rjmdhr/Blinky-5.0/README.md

# Blinky-5.0
A "hello world" intro to PCB design provided by Contextual Electronics. I thought I should start out small before I get into more advanced projects I have in mind.

pcb-gif
