rjmdhr/Blinky-5.0/src/Blinky-5.0.kicad_pcb

## KiCad design src/Blinky-5.0.kicad_pcb (2021-05-21)

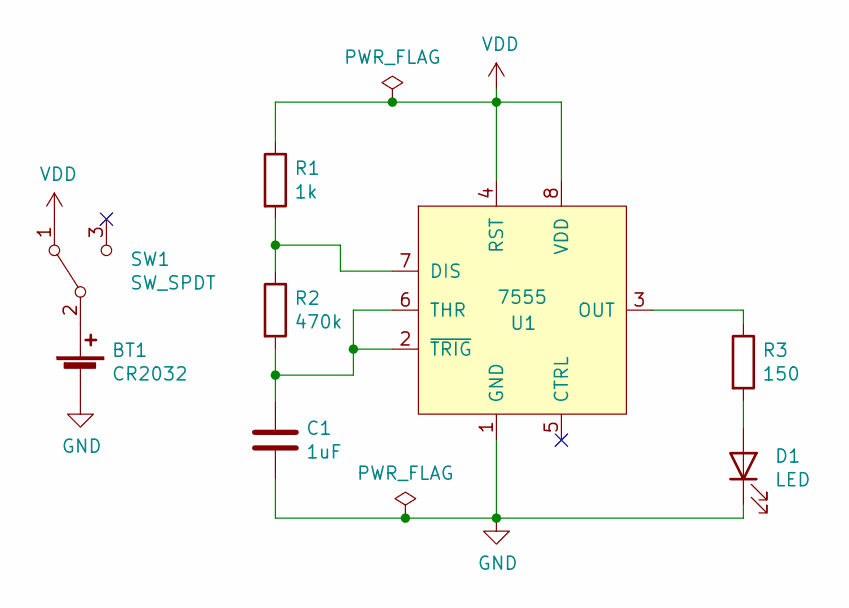
[picture p11: schematic Blinky-5.0.sch]

Parts:
BT1: CR2032; 3034
C1: 1uF; C_1206_3216Metric_Pad1.33x1.80mm_HandSolder
D1: LED; LED_1206_3216Metric_Pad1.42x1.75mm_HandSolder
R1: 1k; R_1206_3216Metric_Pad1.30x1.75mm_HandSolder
R2: 470k; R_1206_3216Metric_Pad1.30x1.75mm_HandSolder
R3: 150; R_1206_3216Metric_Pad1.30x1.75mm_HandSolder
SW1: SW_SPDT; JS102011SCQN
U1: 7555; SOIC-8_3.9x4.9mm_P1.27mm

Connections:
GND: BT1.2 (-), C1.2, D1.1 (K), U1.1 (GND)
unnamed: BT1.1 (+), SW1.2 (B)
unnamed: C1.1, R2.2, U1.2 (~TRIG), U1.6 (THR)
unnamed: D1.2 (A), R3.2
unnamed: R1.2, R2.1, U1.7 (DIS)
unnamed: R3.1, U1.3 (OUT)
VDD: R1.1, SW1.1 (A), U1.4 (RST), U1.8 (VDD)

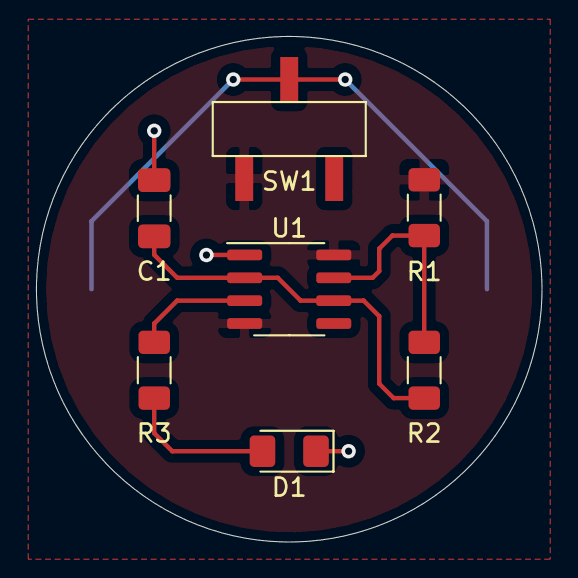
[picture p12: board Blinky-5.0.kicad_pcb from above]

Board: 2 copper layers, 28.1 x 28.1 mm, 8 parts (1 on the bottom side), 7 nets.
