rjmdhr/Blinky-5.0/(commit log)

2021-05-03 Add documentation and source folders
    [Blinky-5.0.kicad_pcb, Blinky-5.0.sch]
2021-05-03 Make schematic
    [Blinky-5.0.sch]
2021-05-05 Add custom library and additions
    [Blinky-5.0.sch]
2021-05-06 Make some custom footprints and define board layout
    [Blinky-5.0.sch]
2021-05-21 Add some changes and finish layout
    [Blinky-5.0.kicad_pcb, Blinky-5.0.sch]
2021-06-14 Add report
    [BOM.xlsx]
